thawney/FlippingDots/dot_flipper.kicad_pcb

## KiCad design dot_flipper.kicad_pcb (2025-03-07)

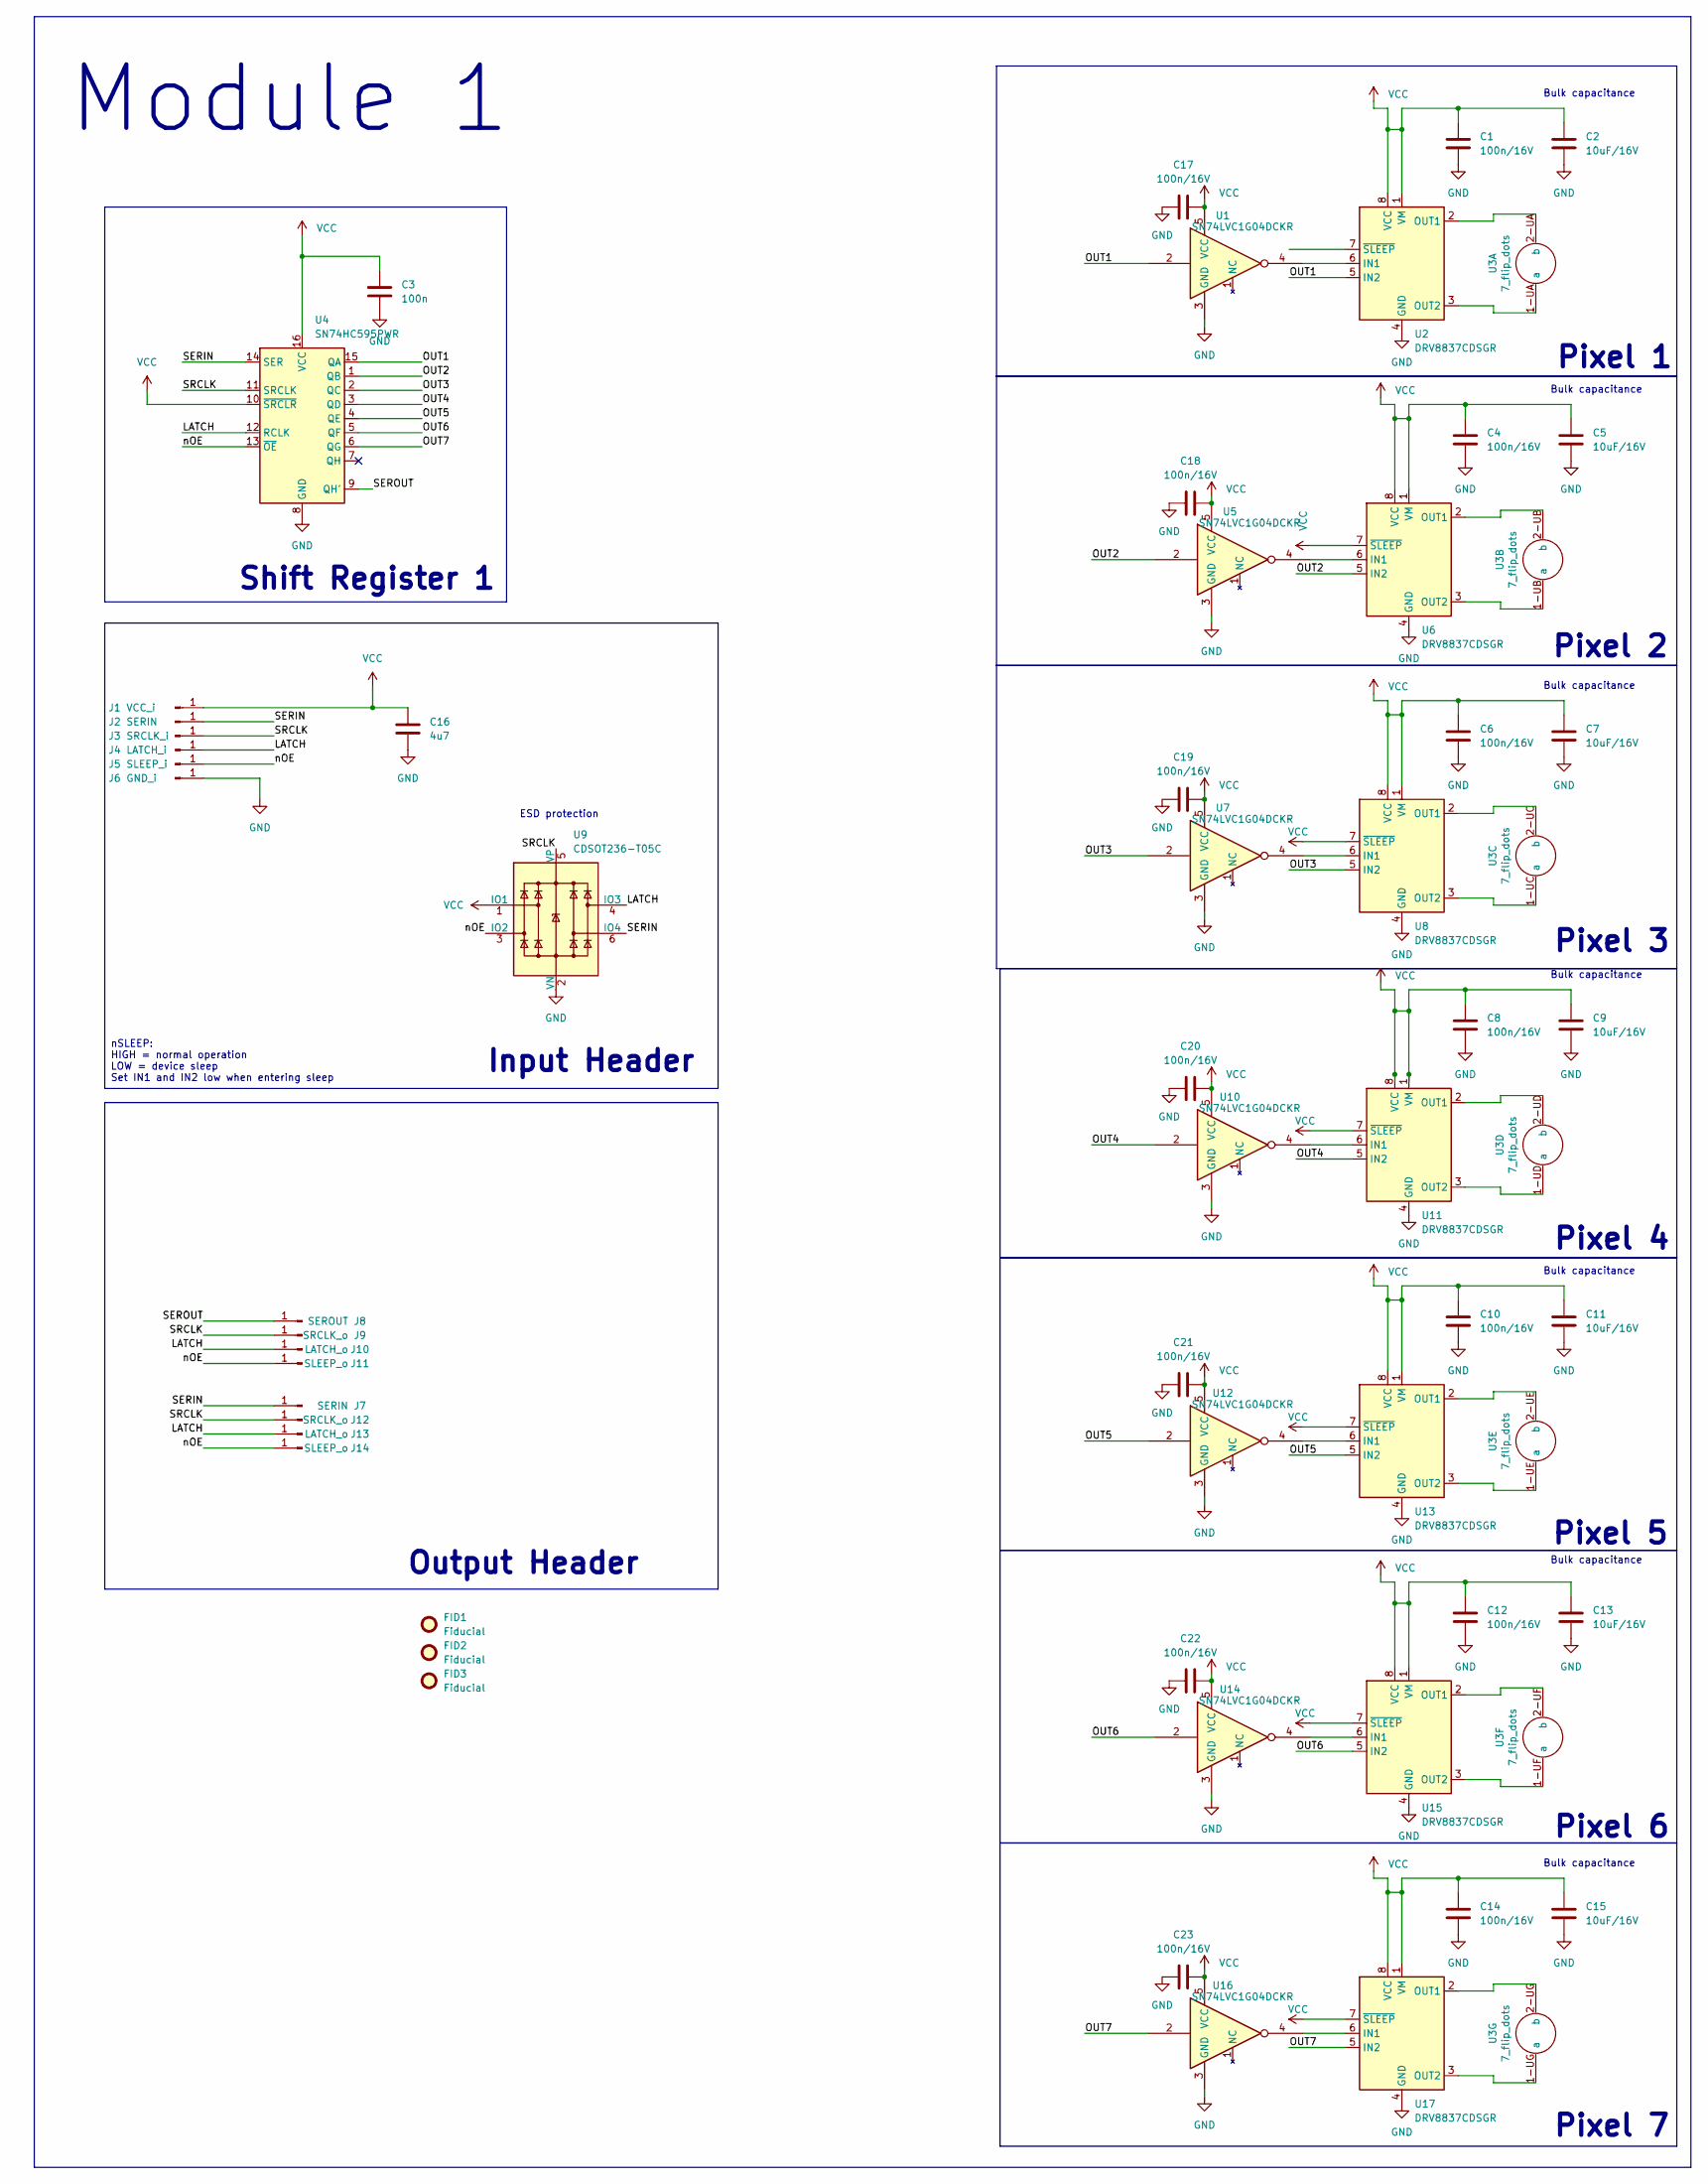
[picture p1: schematic dot_flipper.kicad_sch]

Parts:
C1, C4, C6, C8, C10, C12, C14, C17, C18, C19, C20, C21, C22, C23: 100n/16V; C_0603_1608Metric
C2, C5, C7, C9, C11, C13, C15: 10uF/16V; C_0603_1608Metric
C3: 100n; C_0603_1608Metric
C16: 4u7; C_0603_1608Metric
FID1, FID2, FID3: Fiducial; Fiducial_0.5mm_Mask1.5mm
J1: VCC_i; SolderWirePad_1x01_SMD_1x2mm
J2: SERIN; SolderWirePad_1x01_SMD_1x2mm
J3: SRCLK_i; SolderWirePad_1x01_SMD_1x2mm
J4: LATCH_i; SolderWirePad_1x01_SMD_1x2mm
J5: SLEEP_i; SolderWirePad_1x01_SMD_1x2mm
J6: GND_i; SolderWirePad_1x01_SMD_1x2mm
J7: SERIN; small_pad
J8: SEROUT; small_pad
J9, J12: SRCLK_o; small_pad
J10, J13: LATCH_o; small_pad
J11, J14: SLEEP_o; small_pad
U1, U5, U7, U10, U12, U14, U16: SN74LVC1G04DCKR; SOT-353_SC-70-5; LCSC C8207
U2, U6, U8, U11, U13, U15, U17: DRV8837CDSGR; WSON-8-1EP_2x2mm_P0.5mm_EP0.9x1.6mm; Digikey 296-47205-1-ND
U3: 7_flip_dots
U4: SN74HC595PWR; TSSOP-16_4.4x5mm_P0.65mm; Digikey 296-23258-1-ND
U9: CDSOT236-T05C; SOT-23-6; Digikey CDSOT236-T05CCT-ND

Connections:
/LATCH: J4.1, J10.1, J13.1, U4.12 (RCLK), U9.4 (IO3)
/OUT1: U1.2, U2.5 (IN2), U4.15 (QA)
/OUT2: U4.1 (QB), U5.2, U6.5 (IN2)
/OUT3: U4.2 (QC), U7.2, U8.5 (IN2)
/OUT4: U4.3 (QD), U10.2, U11.5 (IN2)
/OUT5: U4.4 (QE), U12.2, U13.5 (IN2)
/OUT6: U4.5 (QF), U14.2, U15.5 (IN2)
/OUT7: U4.6 (QG), U16.2, U17.5 (IN2)
/SERIN: J2.1, J7.1, U4.14 (SER), U9.6 (IO4)
/SEROUT: J8.1, U4.9 (QH')
/SRCLK: J3.1, J9.1, J12.1, U4.11 (SRCLK), U9.5 (VP)
/nOE: J5.1, J11.1, J14.1, U4.13 (~OE), U9.3 (IO2)
GND: C1.2, C2.2, C3.2, C4.2, C5.2, C6.2, C7.2, C8.2, C9.2, C10.2, C11.2, C12.2, C13.2, C14.2, C15.2, C16.2, C17.1, C18.1, C19.1, C20.1, C21.1, C22.1, C23.1, J6.1, U1.3 (GND), U2.4 (GND), U2.9 (GND), U4.8 (GND), U5.3 (GND), U6.4 (GND), U6.9 (GND), U7.3 (GND), U8.4 (GND), U8.9 (GND), U9.2 (VN), U10.3 (GND), U11.4 (GND), U11.9 (GND), U12.3 (GND), U13.4 (GND), U13.9 (GND), U14.3 (GND), U15.4 (GND), U15.9 (GND), U16.3 (GND), U17.4 (GND), U17.9 (GND)
unnamed: U1.4, U2.6 (IN1)
unnamed: U2.2 (OUT1), U3.2-UA (b)
unnamed: U2.3 (OUT2), U3.1-UA (a)
unnamed: U3.1-UB (a), U6.3 (OUT2)
unnamed: U3.2-UB (b), U6.2 (OUT1)
unnamed: U3.1-UC (a), U8.3 (OUT2)
unnamed: U3.2-UC (b), U8.2 (OUT1)
unnamed: U5.4, U6.6 (IN1)
unnamed: U7.4, U8.6 (IN1)
unnamed: U10.4, U11.6 (IN1)
unnamed: U3.2-UD (b), U11.2 (OUT1)
unnamed: U3.1-UD (a), U11.3 (OUT2)
unnamed: U12.4, U13.6 (IN1)
unnamed: U3.2-UE (b), U13.2 (OUT1)
unnamed: U3.1-UE (a), U13.3 (OUT2)
unnamed: U14.4, U15.6 (IN1)
unnamed: U3.2-UF (b), U15.2 (OUT1)
unnamed: U3.1-UF (a), U15.3 (OUT2)
unnamed: U16.4, U17.6 (IN1)
unnamed: U3.2-UG (b), U17.2 (OUT1)
unnamed: U3.1-UG (a), U17.3 (OUT2)
VCC: C1.1, C2.1, C3.1, C4.1, C5.1, C6.1, C7.1, C8.1, C9.1, C10.1, C11.1, C12.1, C13.1, C14.1, C15.1, C16.1, C17.2, C18.2, C19.2, C20.2, C21.2, C22.2, C23.2, J1.1, U1.5 (VCC), U2.1 (VM), U2.8 (VCC), U4.10 (~SRCLR), U4.16 (VCC), U5.5 (VCC), U6.1 (VM), U6.7 (~SLEEP), U6.8 (VCC), U7.5 (VCC), U8.1 (VM), U8.7 (~SLEEP), U8.8 (VCC), U9.1 (IO1), U10.5 (VCC), U11.1 (VM), U11.7 (~SLEEP), U11.8 (VCC), U12.5 (VCC), U13.1 (VM), U13.7 (~SLEEP), U13.8 (VCC), U14.5 (VCC), U15.1 (VM), U15.7 (~SLEEP), U15.8 (VCC), U16.5 (VCC), U17.1 (VM), U17.7 (~SLEEP), U17.8 (VCC)

Notes on the sheet:
Bulk capacitance
Output Header
Pixel 7
Pixel 6
ESD protection
Pixel 1
Module 1
Pixel 2
Input Header
Shift Register 1
Pixel 3
Pixel 5
Pixel 4
nSLEEP: HIGH = normal operation LOW = device sleep Set IN1 and IN2 low when entering sleep

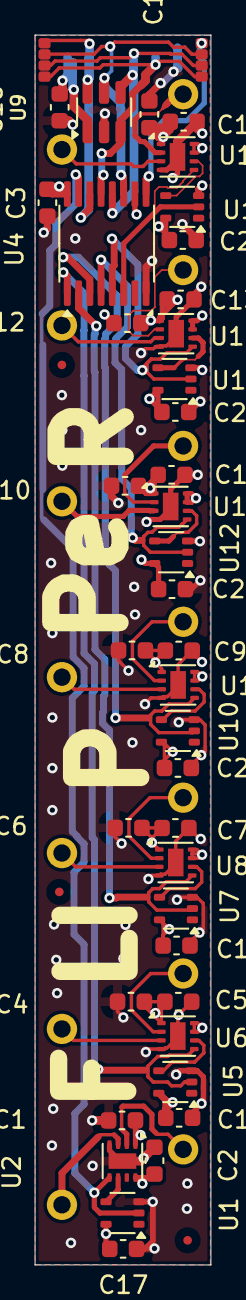
[picture p2: board dot_flipper.kicad_pcb from above]

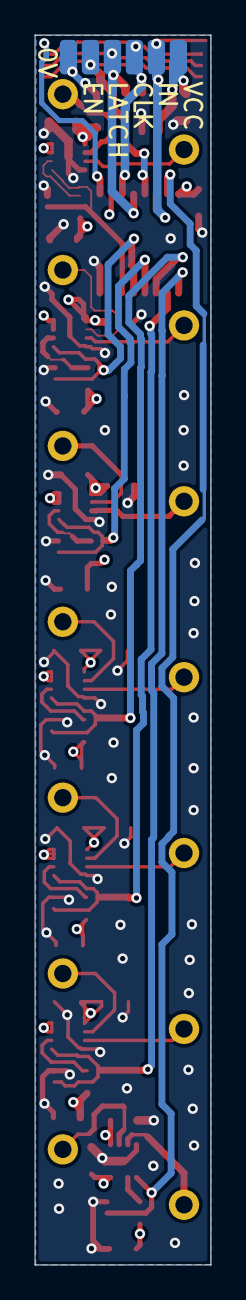
[picture p3: board dot_flipper.kicad_pcb from below]

Board: 4 copper layers, 10.2 x 71.0 mm, 57 parts (6 on the bottom side), 35 nets.
