thawney/FlippingDots/(commit log)

2025-01-24 landscaped schem
    [dot_flipper.kicad_sch]
2025-01-24 Add DRV8837C
    [dot_flipper.kicad_sch]
2025-01-24 added power schematic
    [power.kicad_sch]
2025-01-24 avoided silly names
    [power.kicad_sch]
2025-01-24 Updated with 2 H-bridges
    [dot_flipper.kicad_sch]
2025-02-16 Single module schematic
    [dot_flipper.kicad_sch]
2025-02-16 Rough component placement
    Slightly tweaked flipdot footprint to match my measurements and datasheet better
    Created board outline, interfaces.
    Rough component placement.
    [dot_flipper.kicad_pcb, dot_flipper.kicad_sch]
2025-02-25 Cost optimisation
    Removed one shift register by adding 7 signal inverters (now only need 7 shift register outputs instead of 14 to control 7 H-bridges)
    [dot_flipper.kicad_sch]
2025-02-25 LCSC codes added
    Also broken out VM pin to input/output headers
    [dot_flipper.kicad_sch]
2025-02-25 Power supply mod
    Connected VM to VCC to simplify operation and make PCB layout easier
    [dot_flipper.kicad_pcb, dot_flipper.kicad_sch]
2025-02-25 Started PCB layout
    Components in vaguely the correct area
    [dot_flipper.kicad_pcb, dot_flipper.kicad_sch]
2025-03-07 Update Mar 7 AM
    - Implemented bus architecture to transfer data to second column, and transport signals down to each pixel
    - simplified schematic more
    - routed first (most difficult) pixel
    [dot_flipper.kicad_pcb, dot_flipper.kicad_sch]
2025-03-07 Update Mar 7 PM
    All pixels routed
    7x7 variant created
    [dot_flipper.kicad_pcb, dot_flipper.kicad_sch]
